zeronounours/pet_feeder/arduino/README.md

# Arduino

## Circuit

### Components

The circuit uses:
- 1 x [Arduino Uno](https://www.amazon.com/Arduino-A000066-ARDUINO-UNO-R3/dp/B008GRTSV6)
- 1 x [Arduino drive shield](https://www.adafruit.com/product/1438)
- 1 x [DC motor with integrated reduction gearbox](https://www.amazon.co.uk/150RPM-Speed-Reduction-Gearbox-Engine/dp/B07P55RLX5)
(6V for 150RPM)
- 2 x 6V battery holders
- 2 x 1kR resistors
- 1 x 200kR rotary potentiometer
- 1 x push button
- 1 x Green LED
- Wires

### Circuit

The circuit wiring is the following:


Additional notes:
- Both the Arduino and the drive shield needs to be powered using a 6V battery
holder.

The above circuit was created using https://www.circuit-diagram.org/editor/.
The file [circuit.cddx](circuit.cddx) can be imported in it.
