zeronounours/pet_feeder/arduino/PetFeeder/README.md

Arduino program
===============

Dependencies
------------

First install the dependencies using `make requirements`.

Ensure `arduino-cli` allows installation of libraries through Git with
`arduino-cli config set library.enable_unsafe_install true`.

Compilation
-----------

Just run `make compile`.

Upload to the board
-------------------

Just run `make upload`.

Both compilation and upload can be performed with `make` or `make all`.

Credits
-------

The code for Snooter comes from Snootlab's code:
https://github.com/Snootlab/Snootor
