zeronounours/pet_feeder/3D_printer/pin.scad

include<config.scad>;
include<modules/pin.scad>;

/*************
 * 3D Models *
 *************/
rabbit_pin();
