zeronounours/pet_feeder/3D_printer/dispenser.scad

include<config.scad>;
include<modules/dispenser.scad>;

/*************
 * 3D Models *
 *************/
dispenser();
