zeronounours/pet_feeder/3D_printer/food_container.scad

include<config.scad>;
include<modules/food_container.scad>;


/*************
 * 3D Models *
 *************/
food_container();
