zeronounours/pet_feeder/3D_printer/lid.scad

include<config.scad>;
include<modules/lid.scad>;


/*************
 * 3D Models *
 *************/
lid();
