zeronounours/pet_feeder/3D_printer/main_case.scad

include<config.scad>;
include<modules/main_case.scad>;


/*************
 * 3D Models *
 *************/
main_case();
