zeronounours/pet_feeder/3D_printer/modules/tube.scad

/***********
 * Modules *
 ***********/
 module tube (h, inner_r, thick, closed=false) {
     difference() {
         cylinder(h, r=inner_r + thick);
         if(closed) {
             translate([0, 0, -1]) cylinder(h + 1 - thick, r=inner_r);

         } else {
            translate([0, 0, -1]) cylinder(h + 2, r=inner_r);
         }
     }
 }

// module to create a longer tube
module long_tube(height, add_length, radius) {
    hull() {
        cylinder(height, r=radius);
        translate([0, -add_length, 0]) cylinder(height, r=radius);
    }
}
