zeronounours/pet_feeder/(list of files, cad)

Other CAD files:
3D_printer/modules/screw.scad
