zeronounours/pet_feeder/(commit log)

2021-09-01 Add the spinner and its container
    [case.scad, complete_feeder.scad, config.scad, screw.scad, spinner_case.scad, tie.scad]
2021-09-01 Add the dispenser
    [case.scad, complete_feeder.scad, dispenser.scad, tube.scad]
2021-09-01 Add food container and food container extension
    [case.scad, complete_feeder.scad, config.scad, dispenser.scad, food_container.scad, food_container_extension.scad, tie.scad]
2021-09-01 Rename case.scad
    [complete_feeder.scad, spinner_case.scad]
2021-09-01 Add the main case
    [complete_feeder.scad, config.scad, dispenser.scad, food_container.scad, main_case.scad]
2021-09-02 Add rabbit pin to the extension
    [complete_feeder.scad, config.scad, food_container.scad, food_container_extension.scad, pin.scad]
2021-09-02 Add more height to the spinner case to prevent blockage
    [complete_feeder.scad, config.scad, spinner_case.scad]
2021-09-02 Reorganize the repo
    [complete_feeder.scad, config.scad, dispenser.scad, food_container.scad, food_container_extension.scad, main_case.scad, pin.scad, screw.scad]
2021-09-02 Add a basic sketch to manage LED and button
2021-09-02 Add control of a DC motor
2021-09-03 Add circuit description
2021-09-03 Move spinner case length to the configuration
    [config.scad, spinner_case.scad]
2021-09-03 Change the motor axis type
    [config.scad, motor.scad, screw.scad]
2021-09-03 Split the main case into lower and upper parts
    [complete_feeder.scad, config.scad, main_case.scad]
2021-09-04 Improve motor 3d model
    [config.scad, motor.scad]
2021-09-04 Add a new piece for motor case
    [complete_feeder.scad, main_case.scad, motor_case.scad]
2021-09-04 parametrize the complete feeder rendering
    [complete_feeder.scad]
2021-09-04 Reworked the size and main module
    Prevent biscuit from blocking at the input hole
    [complete_feeder.scad, config.scad, dispenser.scad, food_container.scad, main_case.scad, screw.scad, spinner_case.scad]
2021-09-05 Start a new design which is a single tower (more stable)
    [config.scad, main_case.scad, motor.scad, motor_case.scad, pin.scad, spinner_case.scad]
2021-09-06 Add missing gaps on spinner case for upper case
    [config.scad, spinner_case.scad]
2021-09-07 Update config and print computed parameters
    [config.scad]
2021-09-08 Add the new design for food container
    [config.scad, food_container.scad]
2021-09-08 Add the new dispenser design
    [dispenser.scad, spinner_case.scad]
2021-09-08 Add the new design for the main case
    [config.scad, main_case.scad, spinner_case.scad]
2021-09-08 Add the complete feeder view
    [complete_feeder.scad, config.scad, food_container.scad, spinner_case.scad]
2021-09-09 Add a bowl decoration
    [bowl.scad, complete_feeder.scad]
2021-10-10 Improve the arduino program: update circuit and timely dispense
    Also improve debug messages
2021-10-11 Add arduino support and make output wider
    [config.scad, spinner_case.scad]
2021-10-11 Adapt the dispenser to the wider output
    [dispenser.scad]
2021-10-11 Add arduino to complete feeder and clear repo
    [complete_feeder.scad, main_case.scad, tie.scad]
2021-10-11 Add control panel to the spinner case
    [config.scad, spinner_case.scad]
2021-10-12 Add a lid to the case
    [complete_feeder.scad, config.scad, lid.scad]
2021-10-26 Turn the pin
    [pin.scad]
2022-02-07 Modify the spinner to add rollers and prevent blockages
    [config.scad, screw.scad]
2022-02-08 Change the dispenser to fit the new spinner
    [config.scad, dispenser.scad, screw.scad, spinner_case.scad, tube.scad]
2022-02-09 Add roller location in spinner case and improve spinner lenght mgmt
    [complete_feeder.scad, config.scad, dispenser.scad, spinner_case.scad]
2022-02-09 Add a roller as decoration
    [complete_feeder.scad, roller.scad, spinner_case.scad]
2022-07-07 Rework the spinner to use a metallic motor attach
    The PLA attach was destroyed too quickly
    [complete_feeder.scad, config.scad, motor_attach.scad, spinner.scad, spinner_case.scad]
